frank26080115/ledpocketwatch/readme.txt

See http://www.frank-zhao.com/ledpocketwatch/ for more details
