frank26080115/ledpocketwatch/circuit/pcb_preview_1.png

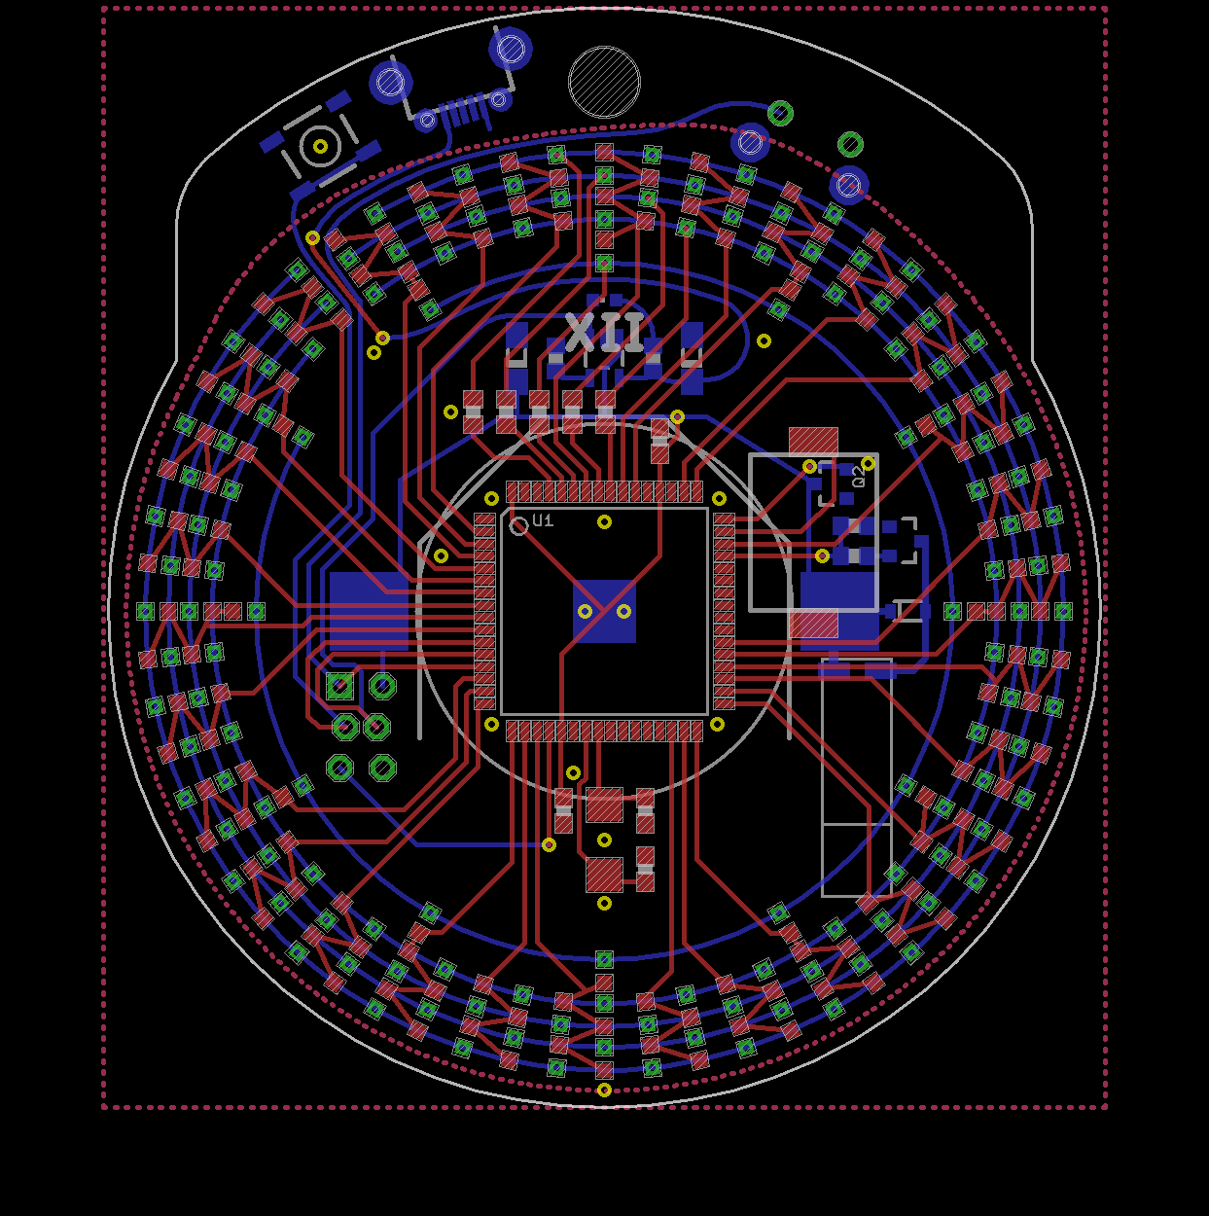
circuit/pcb_preview_1.png
