frank26080115/ledpocketwatch/circuit/pcb_preview_2.png

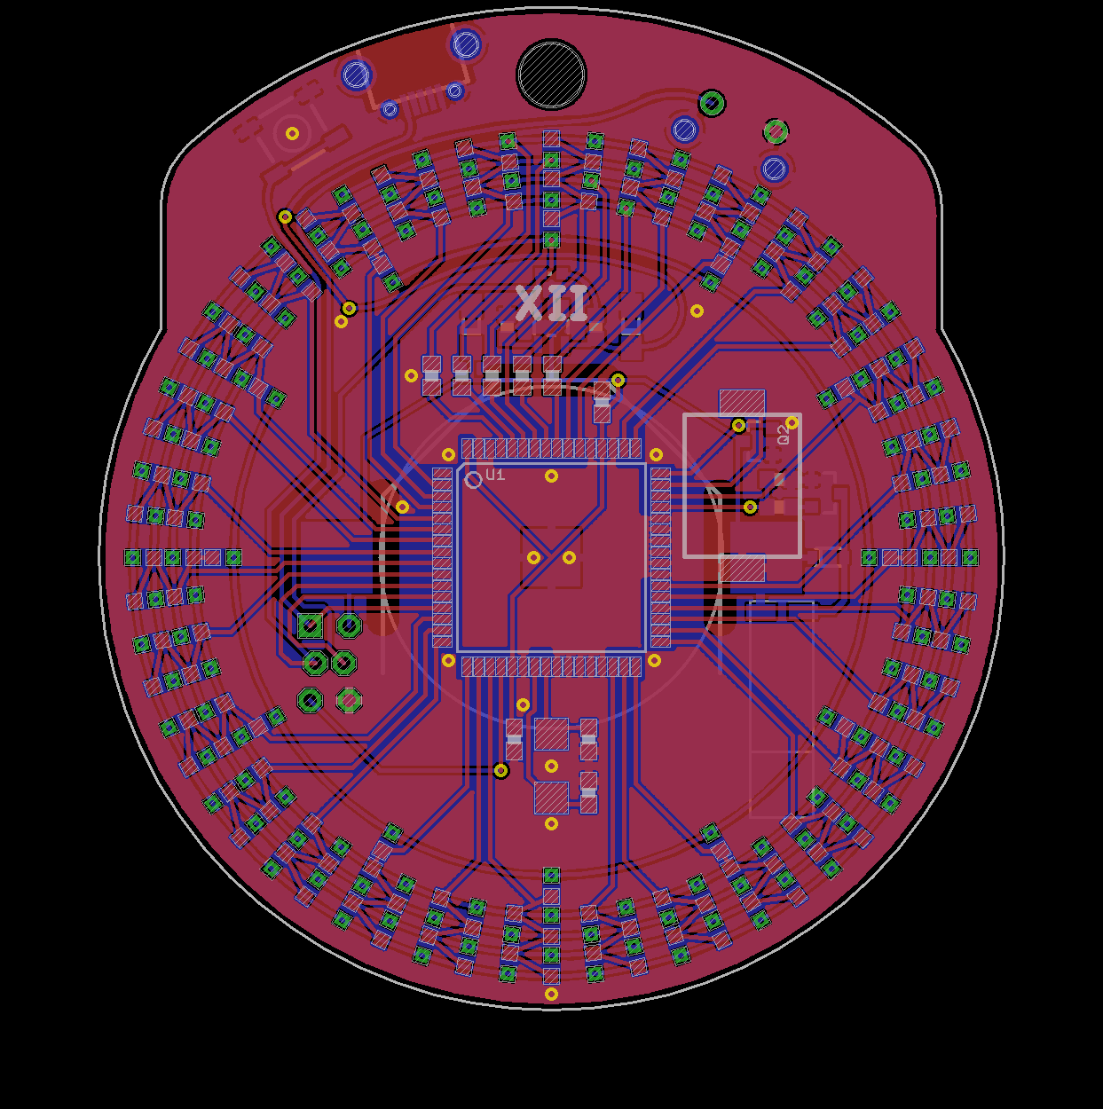
circuit/pcb_preview_2.png
