frank26080115/ledpocketwatch/circuit/sch_sheet_1.png

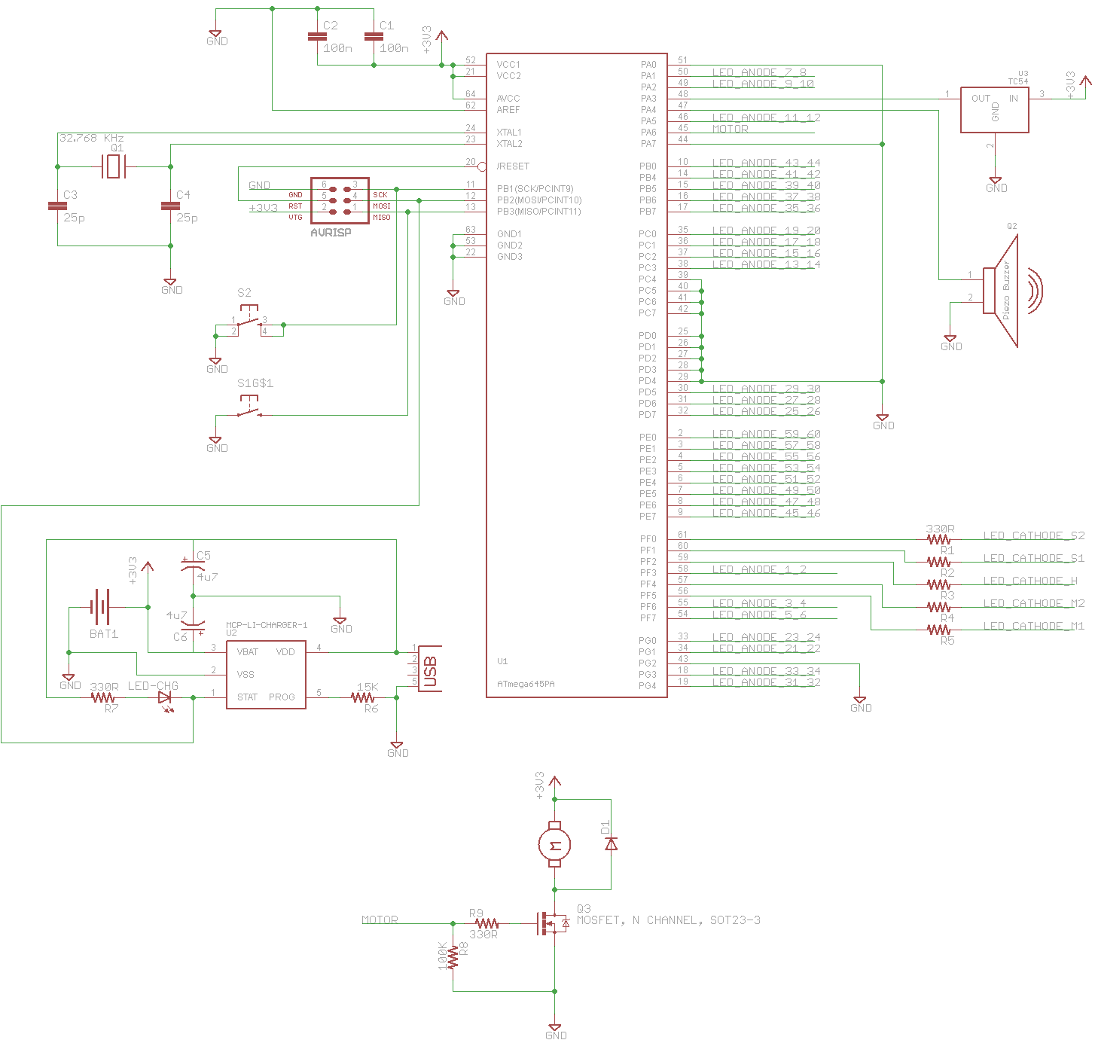
circuit/sch_sheet_1.png
