frank26080115/ledpocketwatch/circuit/sch_sheet_2.png

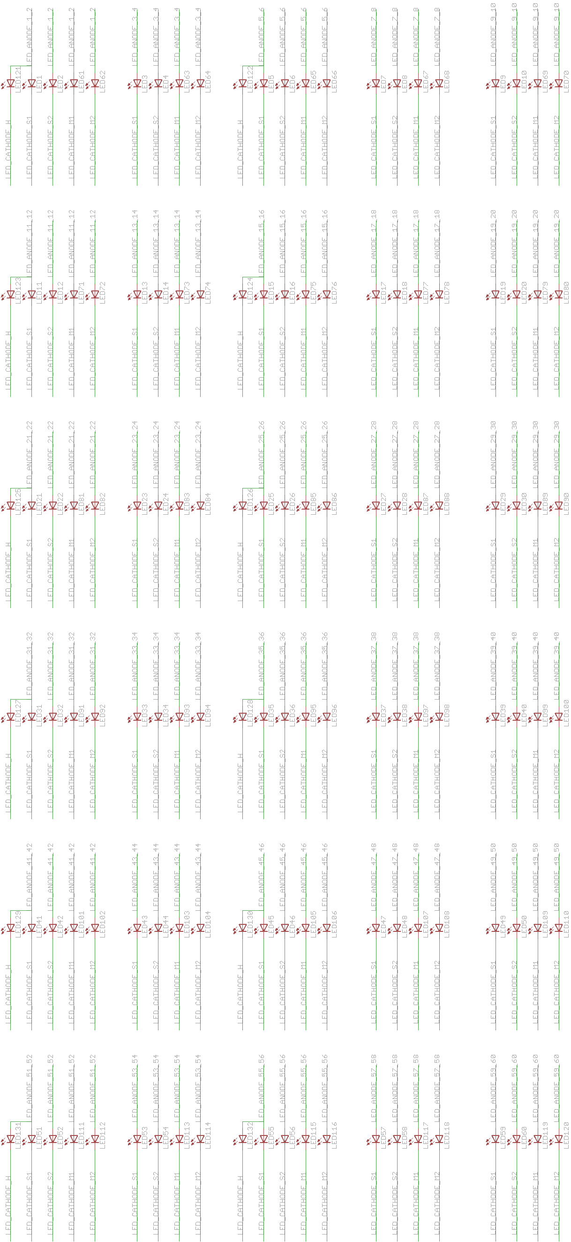
circuit/sch_sheet_2.png
