frank26080115/ledpocketwatch/3d_print/case and button.SLDASM

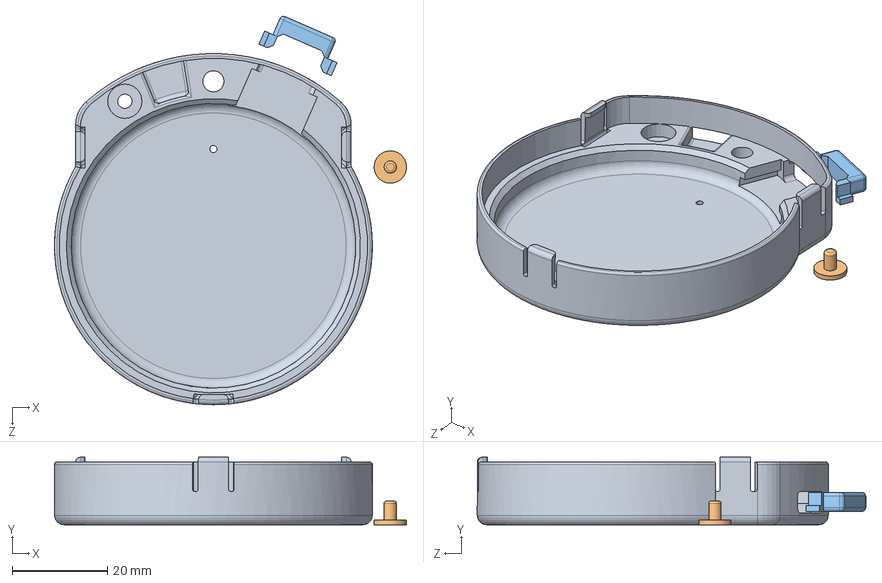
[picture p5: CAD file, 2012-11-05]
3d_print/case and button.SLDASM
73.9 x 14.2 x 81.6 mm
case
