frank26080115/ledpocketwatch/3d_print/case.SLDPRT

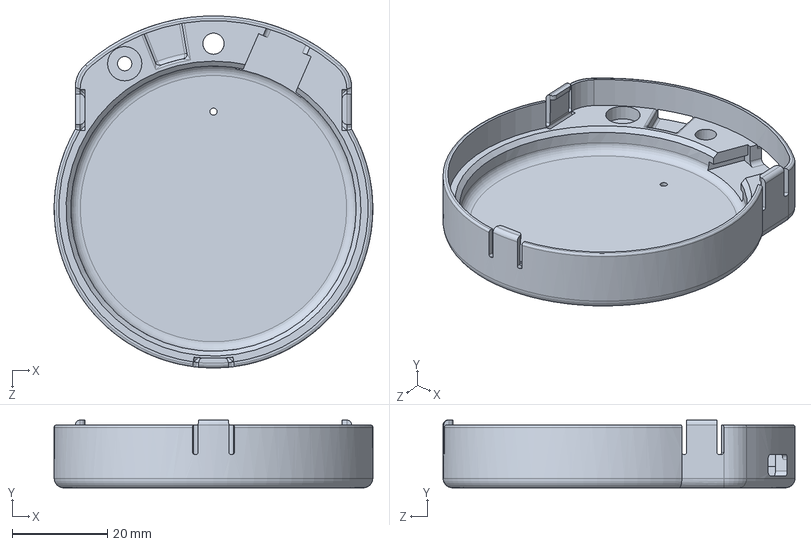
[picture p7: CAD file, 2012-11-05]
3d_print/case.SLDPRT
66.8 x 14.2 x 73.7 mm
