frank26080115/ledpocketwatch/laser_cut/3d/middle 2.SLDPRT

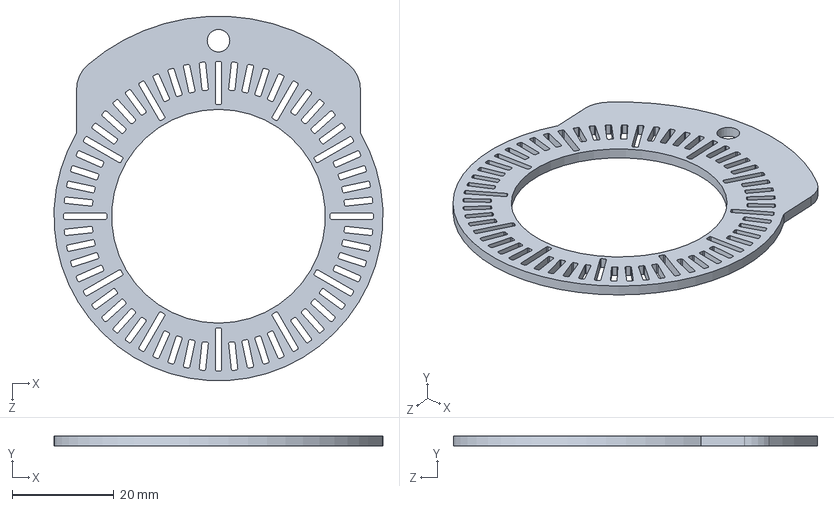
[picture p8: CAD file, 2012-10-29]
laser_cut/3d/middle 2.SLDPRT
64.7 x 2.00 x 71.6 mm
