frank26080115/ledpocketwatch/circuit/pocketwatch.brd

## EAGLE design circuit/pocketwatch.brd (2012-11-05)

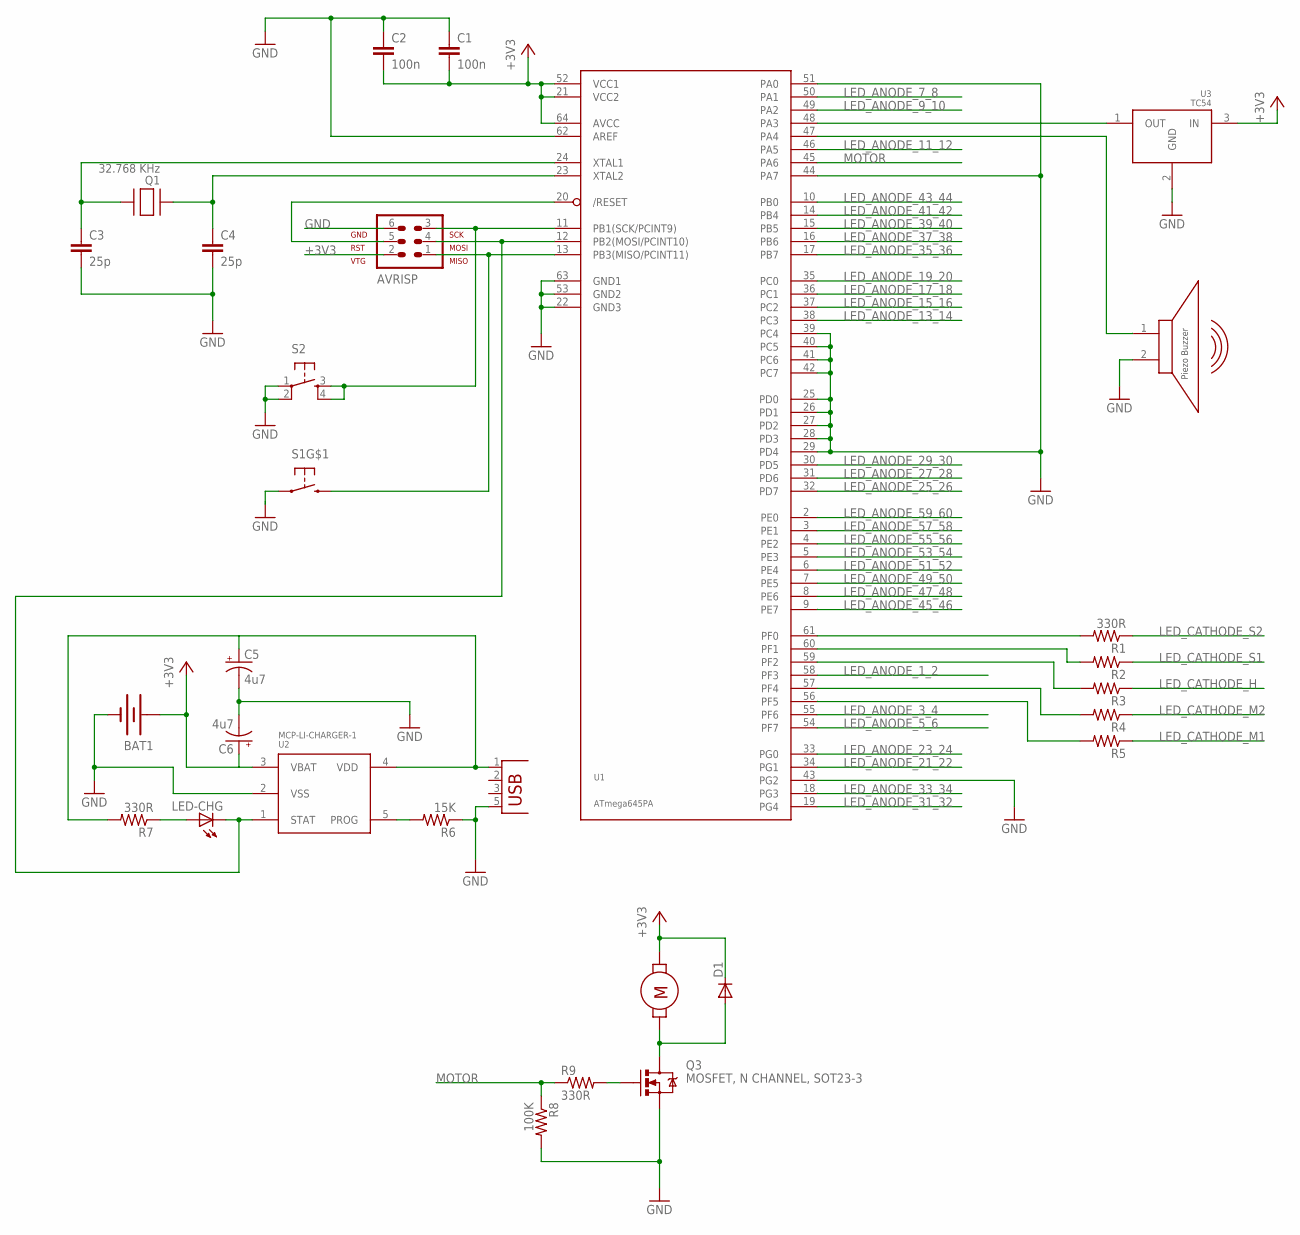
[picture p10: schematic pocketwatch.sch, sheet 1]

Parts:
AVRISP: AVR-ISP-6
BAT1: BATTERY245MM; BATTCON_245MM
C1, C2: 100n; C0603
C3, C4: 25p; C0603
C5, C6: 4u7; SMC_A
D1: DIODESOD; SOD-323
LED-CHG: LEDCHIPLED_0603; CHIPLED_0603
M1: MOTOR; VIBRATION-MOTOR
Q1: 32.768 KHz; XTAL_2SMD
Q2: BUZZER; BUZZER_1
Q3: MOSFET, N CHANNEL, SOT23-3; SOT23-3
R1, R7, R9: 330R; R0603
R2, R3, R4, R5: R-US_R0603; R0603
R6: 15K; R0603
R8: 100K; R0603
S1: TAC_SWITCH_SINGLE; TAC_SWITCH_SIDE_1
S2: TAC_SWITCHSMD; TACTILE_SWITCH_SMD
U1: ATmega645PA; TQFP64
U2: MCP-LI-CHARGER-1; SOT23-5
U3: TC54; SOT23-3
X1: USB-MICRO_B; USB_MICRO_B

Connections:
+3V3: AVRISP.2 (VTG), BAT1.1 (+), C1.2, C2.2, C6.+, D1.1 (C), M1.P$1, U1.21 (VCC2), U1.52 (VCC1), U1.64 (AVCC), U2.3 (VBAT), U3.3 (IN)
GND: AVRISP.6 (GND), BAT1.2 (-), C1.1, C2.1, C3.2, C4.2, C5.-, C6.-, Q2.2, Q3.2 (S), R6.1, R8.2, S1.G1, S1.G2, S1.P$2 (1), S2.1, S2.2, U1.22 (GND3), U1.25 (PD0), U1.26 (PD1), U1.27 (PD2), U1.28 (PD3), U1.29 (PD4), U1.39 (PC4), U1.40 (PC5), U1.41 (PC6), U1.42 (PC7), U1.43 (PG2), U1.44 (PA7), U1.51 (PA0), U1.53 (GND2), U1.62 (AREF), U1.63 (GND1), U2.2 (VSS), U3.2 (GND), X1.5 (GND), X1.P$3, X1.P$4, X1.P$7, X1.P$8
LED_ANODE_1_2: U1.58 (PF3); also elsewhere on the board
LED_ANODE_3_4: U1.55 (PF6); also elsewhere on the board
LED_ANODE_5_6: U1.54 (PF7); also elsewhere on the board
LED_ANODE_7_8: U1.50 (PA1); also elsewhere on the board
LED_ANODE_9_10: U1.49 (PA2); also elsewhere on the board
LED_ANODE_11_12: U1.46 (PA5); also elsewhere on the board
LED_ANODE_13_14: U1.38 (PC3); also elsewhere on the board
LED_ANODE_15_16: U1.37 (PC2); also elsewhere on the board
LED_ANODE_17_18: U1.36 (PC1); also elsewhere on the board
LED_ANODE_19_20: U1.35 (PC0); also elsewhere on the board
LED_ANODE_21_22: U1.34 (PG1); also elsewhere on the board
LED_ANODE_23_24: U1.33 (PG0); also elsewhere on the board
LED_ANODE_25_26: U1.32 (PD7); also elsewhere on the board
LED_ANODE_27_28: U1.31 (PD6); also elsewhere on the board
LED_ANODE_29_30: U1.30 (PD5); also elsewhere on the board
LED_ANODE_31_32: U1.19 (PG4); also elsewhere on the board
LED_ANODE_33_34: U1.18 (PG3); also elsewhere on the board
LED_ANODE_35_36: U1.17 (PB7); also elsewhere on the board
LED_ANODE_37_38: U1.16 (PB6); also elsewhere on the board
LED_ANODE_39_40: U1.15 (PB5); also elsewhere on the board
LED_ANODE_41_42: U1.14 (PB4); also elsewhere on the board
LED_ANODE_43_44: U1.10 (PB0); also elsewhere on the board
LED_ANODE_45_46: U1.9 (PE7); also elsewhere on the board
LED_ANODE_47_48: U1.8 (PE6); also elsewhere on the board
LED_ANODE_49_50: U1.7 (PE5); also elsewhere on the board
LED_ANODE_51_52: U1.6 (PE4); also elsewhere on the board
LED_ANODE_53_54: U1.5 (PE3); also elsewhere on the board
LED_ANODE_55_56: U1.4 (PE2); also elsewhere on the board
LED_ANODE_57_58: U1.3 (PE1); also elsewhere on the board
LED_ANODE_59_60: U1.2 (PE0); also elsewhere on the board
LED_CATHODE_H: R3.1; also elsewhere on the board
LED_CATHODE_M1: R5.1; also elsewhere on the board
LED_CATHODE_M2: R4.1; also elsewhere on the board
LED_CATHODE_S1: R2.1; also elsewhere on the board
LED_CATHODE_S2: R1.1; also elsewhere on the board
MOTOR: R8.1, R9.1, U1.45 (PA6)
unnamed: AVRISP.3 (SCK), S2.3, S2.4, U1.11 (PB1(SCK/PCINT9))
unnamed: D1.2 (A), M1.P$2, Q3.3 (D)
unnamed: AVRISP.1 (MISO), S1.P$1 (2), U1.13 (PB3(MISO/PCINT11))
unnamed: AVRISP.5 (RST), U1.20 (/RESET)
unnamed: R1.2, U1.61 (PF0)
unnamed: R2.2, U1.60 (PF1)
unnamed: C4.1, Q1.1, U1.23 (XTAL2)
unnamed: C3.1, Q1.2, U1.24 (XTAL1)
unnamed: R3.2, U1.59 (PF2)
unnamed: R4.2, U1.57 (PF4)
unnamed: R5.2, U1.56 (PF5)
unnamed: C5.+, R7.2, U2.4 (VDD), X1.1 (VBUS)
unnamed: R6.2, U2.5 (PROG)
unnamed: AVRISP.4 (MOSI), LED-CHG.C, U1.12 (PB2(MOSI/PCINT10)), U2.1 (STAT)
unnamed: LED-CHG.A, R7.1
unnamed: U1.48 (PA3), U3.1 (OUT)
unnamed: Q2.1, U1.47 (PA4)
unnamed: Q3.1 (G), R9.2

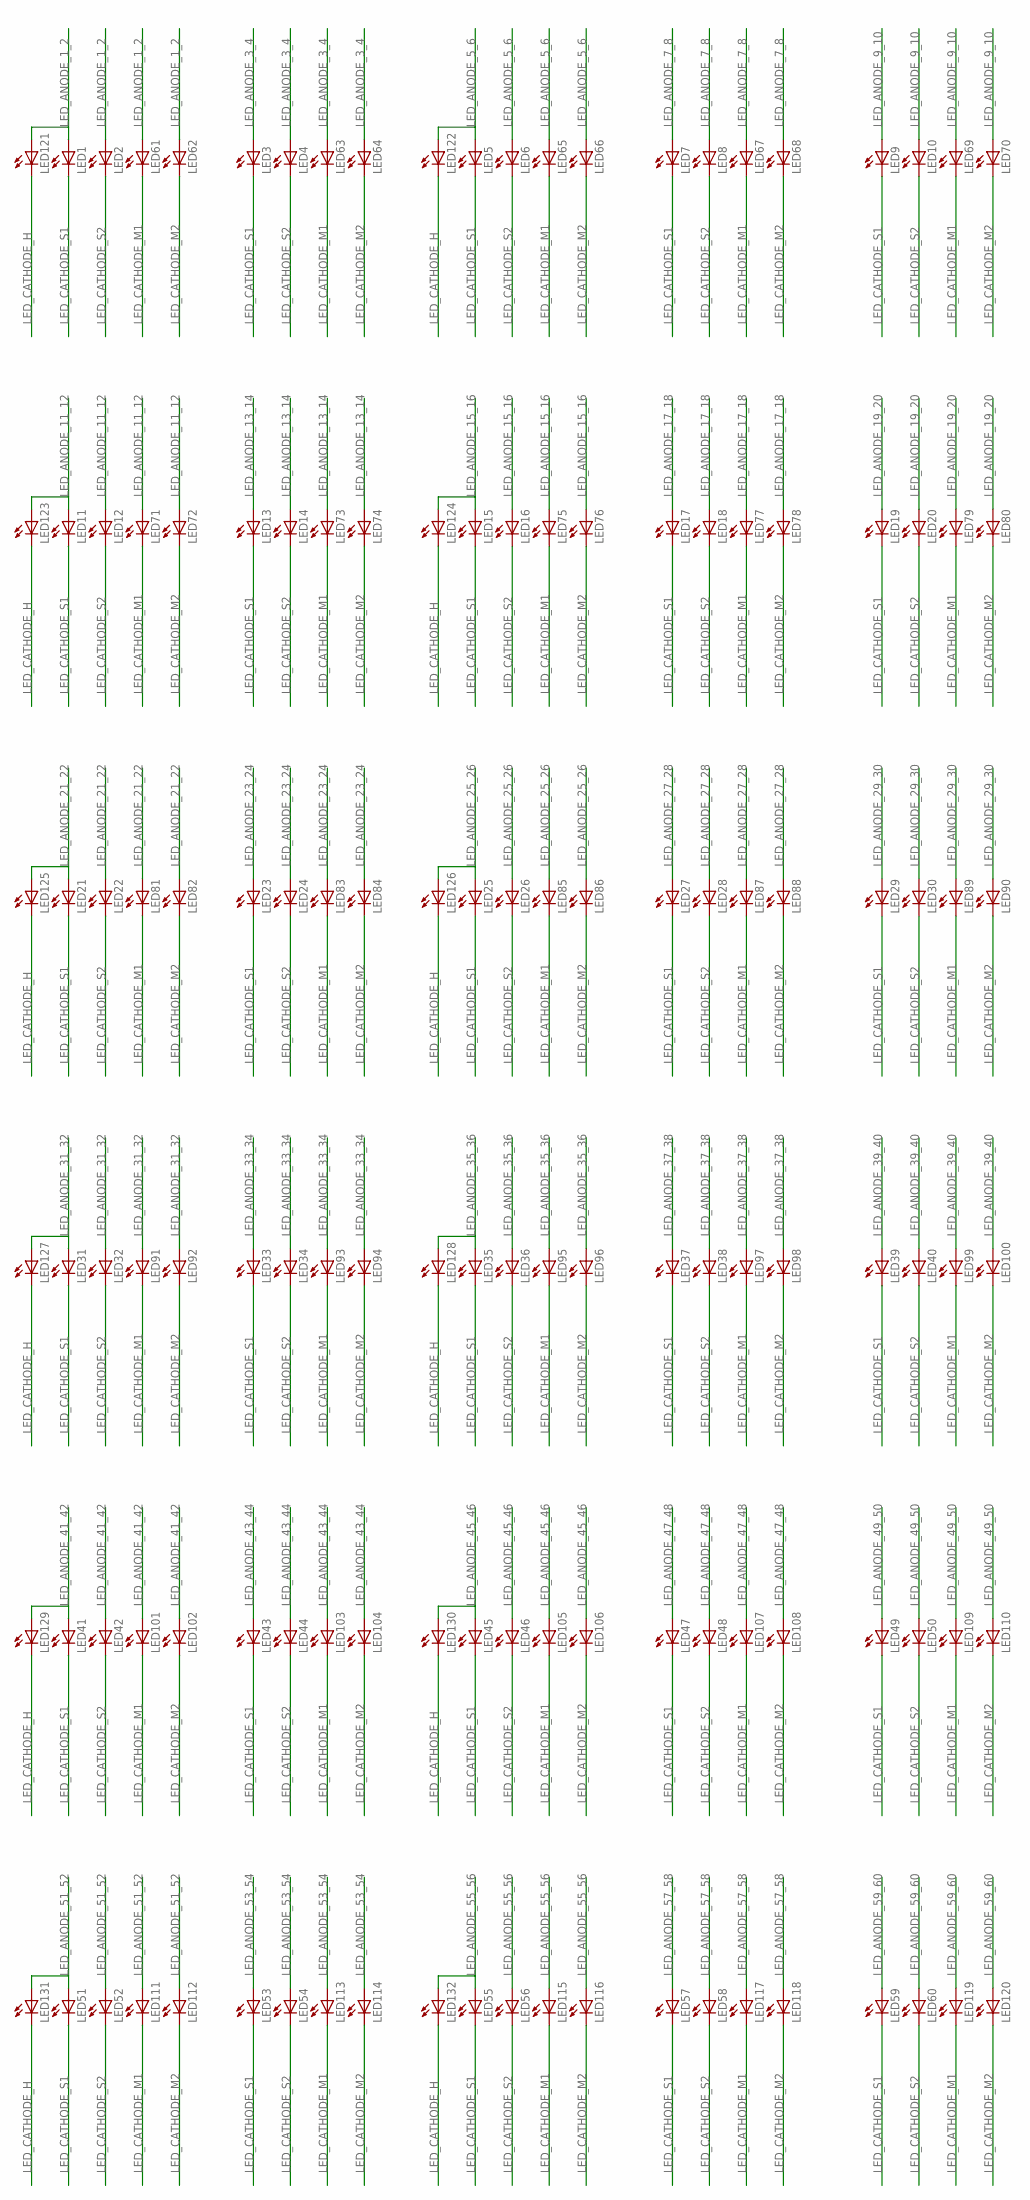
[picture p11: schematic pocketwatch.sch, sheet 2]

Parts:
LED1, LED2, LED3, LED4, LED5, LED6, LED7, LED8, LED9, LED10, LED11, LED12, LED13, LED14, LED15, LED16, LED17, LED18, LED19, LED20, LED21, LED22, LED23, LED24, LED25, LED26, LED27, LED28, LED29, LED30, LED31, LED32, LED33, LED34, LED35, LED36, LED37, LED38, LED39, LED40, LED41, LED42, LED43, LED44, LED45, LED46, LED47, LED48, LED49, LED50, LED51, LED52, LED53, LED54, LED55, LED56, LED57, LED58, LED59, LED60, LED61, LED62, LED63, LED64, LED65, LED66, LED67, LED68, LED69, LED70, LED71, LED72, LED73, LED74, LED75, LED76, LED77, LED78, LED79, LED80, LED81, LED82, LED83, LED84, LED85, LED86, LED87, LED88, LED89, LED90, LED91, LED92, LED93, LED94, LED95, LED96, LED97, LED98, LED99, LED100, LED101, LED102, LED103, LED104, LED105, LED106, LED107, LED108, LED109, LED110, LED111, LED112, LED113, LED114, LED115, LED116, LED117, LED118, LED119, LED120, LED121, LED122, LED123, LED124, LED125, LED126, LED127, LED128, LED129, LED130, LED131, LED132: LED_CHIPLED_0603_VIA_C; CHIPLED_0603_VIA_C

Connections:
LED_ANODE_1_2: LED1.A, LED2.A, LED61.A, LED62.A, LED121.A; also elsewhere on the board
LED_ANODE_3_4: LED3.A, LED4.A, LED63.A, LED64.A; also elsewhere on the board
LED_ANODE_5_6: LED5.A, LED6.A, LED65.A, LED66.A, LED122.A; also elsewhere on the board
LED_ANODE_7_8: LED7.A, LED8.A, LED67.A, LED68.A; also elsewhere on the board
LED_ANODE_9_10: LED9.A, LED10.A, LED69.A, LED70.A; also elsewhere on the board
LED_ANODE_11_12: LED11.A, LED12.A, LED71.A, LED72.A, LED123.A; also elsewhere on the board
LED_ANODE_13_14: LED13.A, LED14.A, LED73.A, LED74.A; also elsewhere on the board
LED_ANODE_15_16: LED15.A, LED16.A, LED75.A, LED76.A, LED124.A; also elsewhere on the board
LED_ANODE_17_18: LED17.A, LED18.A, LED77.A, LED78.A; also elsewhere on the board
LED_ANODE_19_20: LED19.A, LED20.A, LED79.A, LED80.A; also elsewhere on the board
LED_ANODE_21_22: LED21.A, LED22.A, LED81.A, LED82.A, LED125.A; also elsewhere on the board
LED_ANODE_23_24: LED23.A, LED24.A, LED83.A, LED84.A; also elsewhere on the board
LED_ANODE_25_26: LED25.A, LED26.A, LED85.A, LED86.A, LED126.A; also elsewhere on the board
LED_ANODE_27_28: LED27.A, LED28.A, LED87.A, LED88.A; also elsewhere on the board
LED_ANODE_29_30: LED29.A, LED30.A, LED89.A, LED90.A; also elsewhere on the board
LED_ANODE_31_32: LED31.A, LED32.A, LED91.A, LED92.A, LED127.A; also elsewhere on the board
LED_ANODE_33_34: LED33.A, LED34.A, LED93.A, LED94.A; also elsewhere on the board
LED_ANODE_35_36: LED35.A, LED36.A, LED95.A, LED96.A, LED128.A; also elsewhere on the board
LED_ANODE_37_38: LED37.A, LED38.A, LED97.A, LED98.A; also elsewhere on the board
LED_ANODE_39_40: LED39.A, LED40.A, LED99.A, LED100.A; also elsewhere on the board
LED_ANODE_41_42: LED41.A, LED42.A, LED101.A, LED102.A, LED129.A; also elsewhere on the board
LED_ANODE_43_44: LED43.A, LED44.A, LED103.A, LED104.A; also elsewhere on the board
LED_ANODE_45_46: LED45.A, LED46.A, LED105.A, LED106.A, LED130.A; also elsewhere on the board
LED_ANODE_47_48: LED47.A, LED48.A, LED107.A, LED108.A; also elsewhere on the board
LED_ANODE_49_50: LED49.A, LED50.A, LED109.A, LED110.A; also elsewhere on the board
LED_ANODE_51_52: LED51.A, LED52.A, LED111.A, LED112.A, LED131.A; also elsewhere on the board
LED_ANODE_53_54: LED53.A, LED54.A, LED113.A, LED114.A; also elsewhere on the board
LED_ANODE_55_56: LED55.A, LED56.A, LED115.A, LED116.A, LED132.A; also elsewhere on the board
LED_ANODE_57_58: LED57.A, LED58.A, LED117.A, LED118.A; also elsewhere on the board
LED_ANODE_59_60: LED59.A, LED60.A, LED119.A, LED120.A; also elsewhere on the board
LED_CATHODE_H: LED121.C, LED122.C, LED123.C, LED124.C, LED125.C, LED126.C, LED127.C, LED128.C, LED129.C, LED130.C, LED131.C, LED132.C; also elsewhere on the board
LED_CATHODE_M1: LED61.C, LED63.C, LED65.C, LED67.C, LED69.C, LED71.C, LED73.C, LED75.C, LED77.C, LED79.C, LED81.C, LED83.C, LED85.C, LED87.C, LED89.C, LED91.C, LED93.C, LED95.C, LED97.C, LED99.C, LED101.C, LED103.C, LED105.C, LED107.C, LED109.C, LED111.C, LED113.C, LED115.C, LED117.C, LED119.C; also elsewhere on the board
LED_CATHODE_M2: LED62.C, LED64.C, LED66.C, LED68.C, LED70.C, LED72.C, LED74.C, LED76.C, LED78.C, LED80.C, LED82.C, LED84.C, LED86.C, LED88.C, LED90.C, LED92.C, LED94.C, LED96.C, LED98.C, LED100.C, LED102.C, LED104.C, LED106.C, LED108.C, LED110.C, LED112.C, LED114.C, LED116.C, LED118.C, LED120.C; also elsewhere on the board
LED_CATHODE_S1: LED1.C, LED3.C, LED5.C, LED7.C, LED9.C, LED11.C, LED13.C, LED15.C, LED17.C, LED19.C, LED21.C, LED23.C, LED25.C, LED27.C, LED29.C, LED31.C, LED33.C, LED35.C, LED37.C, LED39.C, LED41.C, LED43.C, LED45.C, LED47.C, LED49.C, LED51.C, LED53.C, LED55.C, LED57.C, LED59.C; also elsewhere on the board
LED_CATHODE_S2: LED2.C, LED4.C, LED6.C, LED8.C, LED10.C, LED12.C, LED14.C, LED16.C, LED18.C, LED20.C, LED22.C, LED24.C, LED26.C, LED28.C, LED30.C, LED32.C, LED34.C, LED36.C, LED38.C, LED40.C, LED42.C, LED44.C, LED46.C, LED48.C, LED50.C, LED52.C, LED54.C, LED56.C, LED58.C, LED60.C; also elsewhere on the board

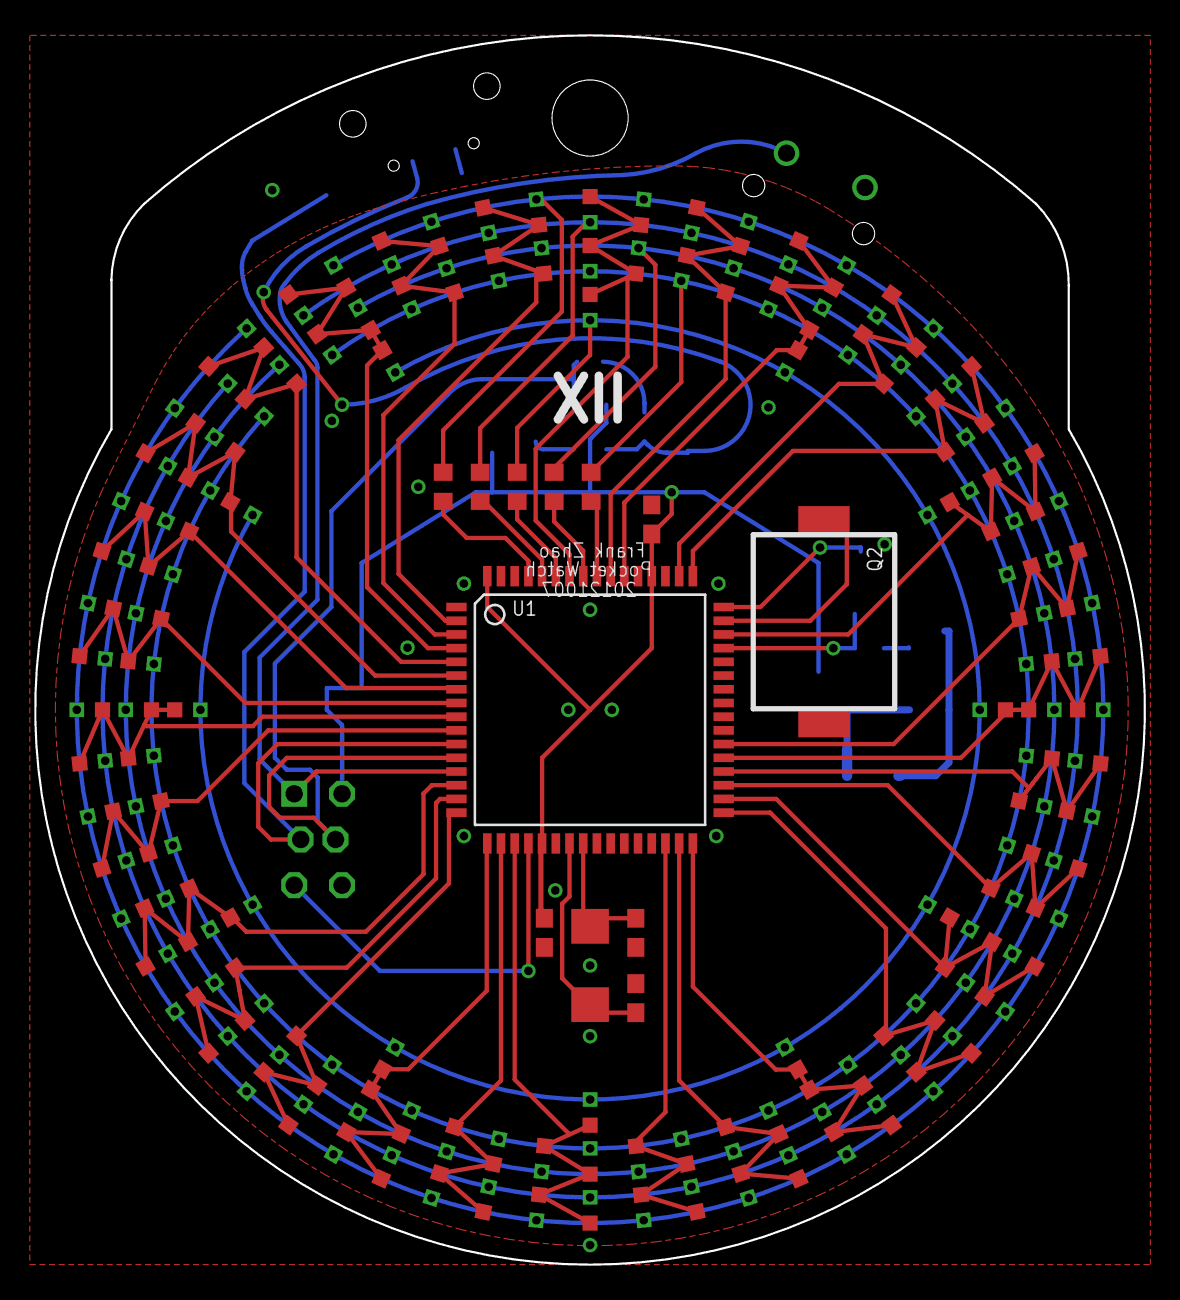
[picture p12: board pocketwatch.brd from above]

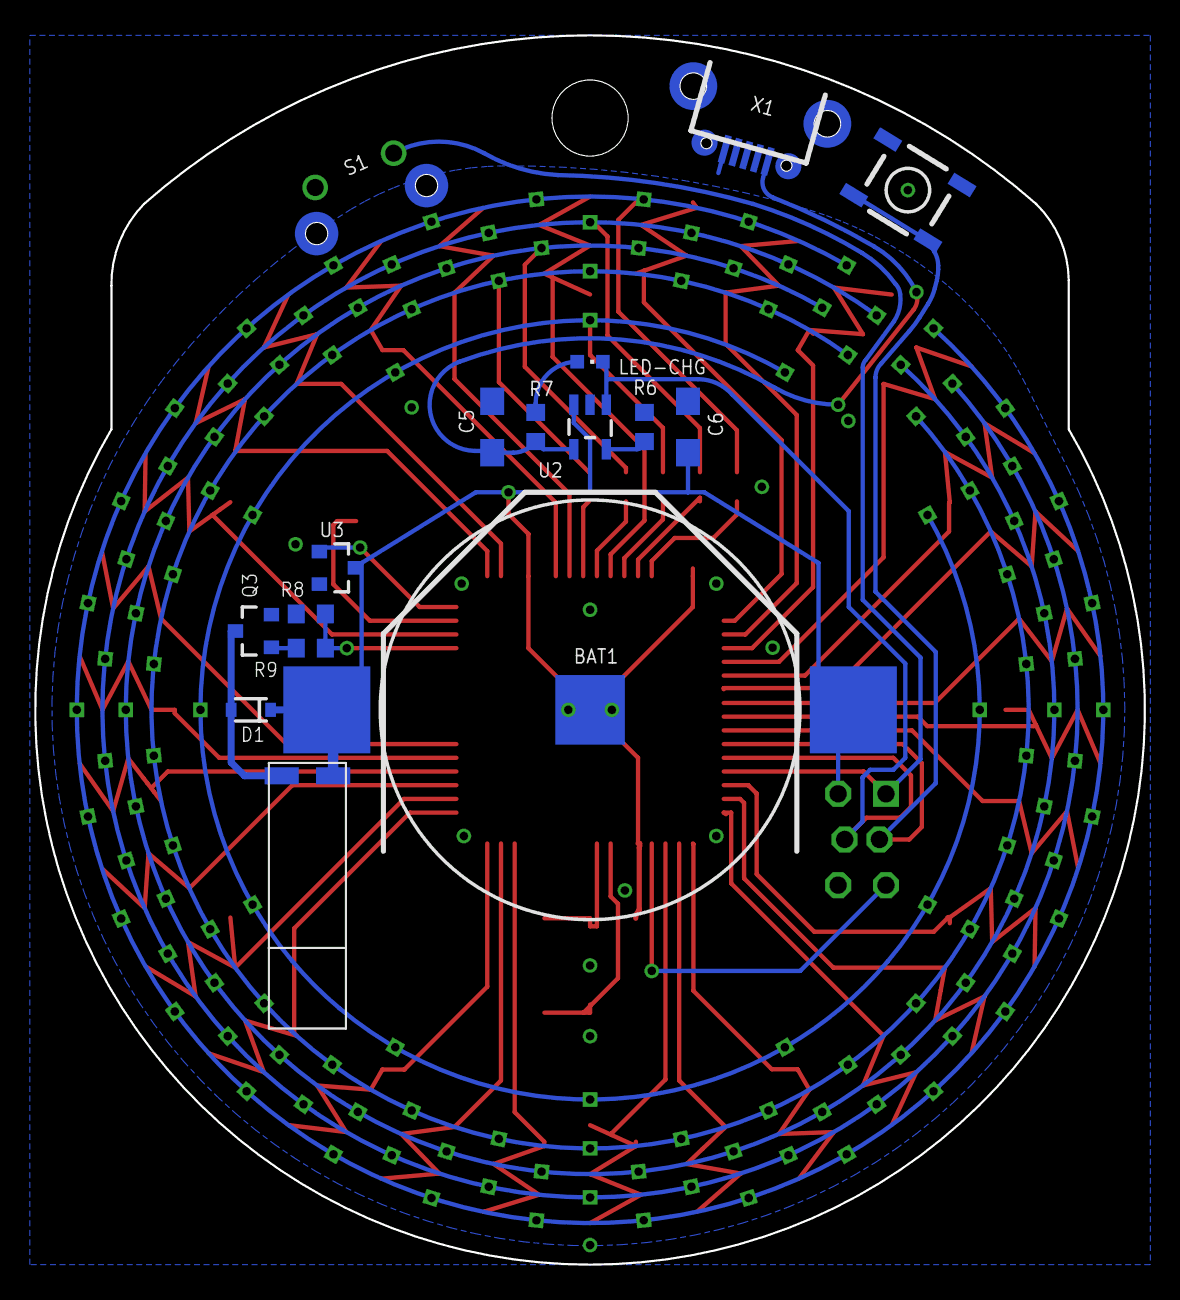
[picture p13: board pocketwatch.brd from below]

Board: 2 copper layers, 64.8 x 71.8 mm, 161 parts (16 on the bottom side), 56 nets.
