frank26080115/ledpocketwatch/(commit log)

2012-10-29 added parts list
    [ledpocketwatch_partlist.csv]
2012-10-30 updated part list
    [ledpocketwatch_partlist.csv]
2012-10-31 edited the main button in the 3D printed case
    [case and button.SLDASM, case.SLDPRT]
2012-11-05 circuit maintainance
    [pocketwatch.brd, pocketwatch.sch]
2012-11-05 3d maintainance
    [case and button.SLDASM, case.SLDPRT]
2012-11-05 corrected small bug regarding alarm setting, also motor tick works
    [PocketWatch.c, pocketwatch.h]
2012-11-05 disable timer0 interrupt during sleep
2012-11-05 animation implemented but buggy so it's disabled
    [PocketWatch.c, pocketwatch.h]
2012-11-11 screen on/off animation now working, fixed other stuff too
    [PocketWatch.c, pocketwatch.h]
2012-11-12 fixed some stuff, looks more like flow chart
    [PocketWatch.c]
